KritSatthaphong/insole-force-monitor/README.md

# Insole Force Monitor

Live per-sensor force map for the A401 smart insole (EU42, 7 sensors per foot), both feet side by side.
Each foot stays greyed out until a board (or Demo) is connected to it.

**Open the app:** https://kritsatthaphong.github.io/insole-force-monitor/ (Chrome / Edge on a computer, Chrome on Android,
Bluefy on iPhone). Press **Demo** to try it without hardware.

| Folder | What |
|---|---|
| `firmware/FSR_Insole_App/` | ESP32-C6 sketch: raw mV of 7 channels at **200 Hz** (v1.4) over USB serial **and** BLE (batched v2 packet), with sample counter and MCU timestamp |
| `insole-app/index.html` | The app (single file, no install) |
| `tools/cal_from_xlsx.py` | Per-sensor loading / unloading fits from the UTM summary workbook (`S1-S7test results.xlsx`) — the app's defaults |
| `tools/fit_cal.py` | Older single-curve fit from the raw UTM CAL CSVs |
| `tools/check_cal.py` | Runs the app's mV → N conversion over a UTM CAL log and reports bias / RMSE / max error |

## 1. Flash the boards
Arduino IDE → board "ESP32C6 Dev Module", core 3.3.x, **USB CDC On Boot: Enabled** (Disabled also builds; then use
the CH343 port). Library: **SparkFun BMI270 Arduino Library** (Library Manager).
Firmware v1.3 also streams the BMI270 IMU (SDA GPIO23, SCL GPIO22; ±16 g, ±2000 °/s, read at 200 Hz) and subtracts the
measured gyro zero offset `GYRO_BIAS = {0.030, -1.175, 0.180}` °/s (mean of three 10 s still measurements); re-measure it if
the IMU board is replaced. The shock value (`apk`) is the peak dynamic acceleration |a − g| with gravity removed
(gravity tracked with the gyro on the board). Send `?`: `|a|` should read ≈ 1.00 g with the board lying still.
Flash the same sketch on both boards, then in Serial Monitor (115200) send `fL` to the left board and `fR` to the right one
(saved in flash; BLE name becomes `Insole-L` / `Insole-R`). Close Serial Monitor before using the app over USB.

## 2. Open the app
- **Laptop (USB or BLE), Chrome or Edge:** in the `insole-app` folder run `python -m http.server 8765`, open http://localhost:8765.
- **Anywhere (USB or BLE, incl. phones):** open the GitHub Pages link above. In **Chrome on Android** it works as is;
  iPhone Safari has no Web Bluetooth, so use the free **Bluefy** browser on iPhone.

Press **USB** / **Bluetooth** on the foot you want. The app zeroes automatically in the first second if the insole is unloaded;
otherwise press **Zero** with the foot off the insole.

## 3. Notes
- Channel → site (heel to toe): ch1 S1, ch2 S4, ch3 S6, ch4 S11, ch5 S13, ch6 S10, ch7 S14.
- Force: G = (mV/base − 1)/39 kΩ, F = a·G^b with each sensor's own fit from `S1-S7test results.xlsx`.
  **Hysteresis compensation** (on by default): the loading curve is used while a sensor's force rises, the unloading curve
  (scaled through the turning point) while it falls; each step starts again on the loading curve. Over 0–300 N this cuts the
  UTM error from 8–15 N to 2–8 N per sensor. Calibration → "Fit from a UTM workbook" fits a new .xlsx/.csv of the same layout
  in the browser (e.g. the right insole's sensors) into Left, Right or both; Save to use it.
  S3 has no unloading leg and S6 (ch6 = site S10, disconnected pins) no loading leg above 57 N: those channels use one curve.
- ≥ 3250 mV = ADC saturated → shown as `SAT` / `≥ value`.
- vGRF = Σ Fᵢ, the plain sum of the 7 calibrated sensor forces (no area or body-weight scaling), so it is the load on the
  sensors only and reads below the true foot load.
- Zero: channels at 250–350 mV set their base (VREF). A channel above that is preloaded: base stays ≈300 mV and the preload is
  subtracted in newtons. All channels high by the same amount → VREF shifted (warning shown).
- Live COP = Σ(rᵢ Fᵢ)/Σ Fᵢ, shown as two tiles, **COP X (ML)** and **COP Y (AP)** in mm, with the origin at the middle of the
  insole outline (X + = right side of the drawing, Y + = toward the toes). The current step's COP path is drawn on the insole
  with dashed centre lines marking X = 0 and Y = 0. Results add COP X / Y curves over % stance, per-step and summary values
  (heel strike, mean, toe-off, min / max) and X / Y over the whole recording; the CSV columns `COPx_mm` / `COPy_mm` use the same origin.
- Record → Stop & save downloads a CSV of every sample (mV, N, Fz, COP) and opens **Results**: gait events, walking
  speed / cadence / step & stride, vGRF peaks, impulse, loading rate, plantar pressure (peak kPa, PTI, contact area, COP path)
  as mean ± SD per foot, plus a per-step table and "Export steps CSV". Results also appear when a foot disconnects mid-recording.
- Walking speed: fill **Distance** (m walked during the recording) — or **Height** for an estimate. **Mass** adds %BW.
- **IMU (firmware v1.1+):** live heel-strike shock, foot pitch and eversion; in Results, IMU stride length and speed
  (zero-velocity updates), foot clearance, strike / toe-off angles, eversion and foot progression angle. Set how the BMI270
  sits in the insole under Calibration → IMU mounting. Default: sensor +Y points down (ay = −1 g standing) and +X to the heel,
  i.e. toe axis −X, up axis −Y. Results plot vGRF, foot pitch and eversion stacked on one % gait-cycle axis, angles 0° at heel strike.
- **BW cal / BW scale:** optional. BW cal on a foot measures factor = body weight / Σ sensor force while standing on that foot;
  the BW scale button multiplies vGRF by it (off by default, so vGRF stays Σ Fᵢ).
- **Calibration check** (in Calibration): runs the app's conversion over the built-in UTM data or a UTM file and shows
  bias / RMSE / max error per channel against ±52 N / ±20 N limits.

## 4. Logging over Bluetooth to a laptop or phone
Connect each foot with **Bluetooth**, press **● Record**, walk, press **■ Stop & save**. No cable or SD card is needed.
- Rows are saved in the browser's storage about once a second (header shows time · rows · saved). If the tab closes, the phone
  sleeps or the page crashes, the log is kept up to that second and appears under **Logs** as "recovered".
- **Logs** lists every recording in this browser: Download (laptop / Android → Downloads), **ZIP** (research export), **XML** (the same raw samples as an XML file),
  Share (phone → Files, Drive, e-mail), Delete. Tick **+ XML** next to ● Record to also download the XML automatically on Stop.
  The XML has one `<Sample>` per CSV row (t_ms, foot, src, Fz_N, COP, 7 `<Sensor id ch mV N>`, optional `<IMU>`), a `<Meta>` block
  with the CSV header lines and a `<Sites>` block with the sensor coordinates. It is about 4 times the CSV size.

## Research export (app 1.5.1-research, firmware 1.4)

For validation studies (e.g. against a pressure treadmill): enter **Participant / Run / Condition / Speed / Mass**, record, and Stop (or Logs → ZIP)
to get `P01_R01/` with `P01_R01_insole_L.csv` (raw mV, forces, CoP, IMU, `sample_seq`, device time `dev_us`, host receive time, validity and saturation masks),
`P01_R01_metadata.json` (calibration, baseline/tare, sensor positions, coordinate frames and the transform to the CAD corner frame, firmware, timing, counts)
and `P01_R01_events.csv` (zero, tare/calibration changes, link loss, packet drops, stream errors). Per-sensor calibration is now **linear**
(`N = m·(mV − baseline)`, from the PVC test on the insole); the earlier curve/hysteresis model is still selectable. Check an export with
`python tools/validate_export.py P01_R01.zip`; check the board itself with `python tools/hw_test_usb.py COM6`. Full documentation, schemas, test results, limits and the pre-lab checklist: [docs/RESEARCH_EXPORT.md](docs/RESEARCH_EXPORT.md).
- A dropped BLE link reconnects by itself for ≈40 s without losing zero, calibration or the recording; the status shows
  "% lost" from the packet counter, and the CSV has `dev_ms` (board time) plus BLE loss in its header line.
- The screen is kept awake while a foot streams over BLE or a recording runs (phones stop Bluetooth in the background):
  keep the app in front.

## UTM calibration test code

Sensor calibration on the Shimadzu UTM: see [`utm-calibration/`](utm-calibration/) (simple hold version and full v3.0 run-recording version, PC logger, pairing tool, results).
Browser logger for those sketches: https://kritsatthaphong.github.io/insole-force-monitor/utm-logger/ (Chrome / Edge).
