KritSatthaphong/insole-force-monitor/utm-calibration/results/S1_cycle1_39k_hold/S1_cycle1_CAL.csv

CAL | ms | ch | cycle | run | run_id | hold | dir | set_N | utm_N | mean_mV | sd_mV | min_mV | max_mV | early_mV | drift_mV | trend_mV | base_mV | rs_kOhm | g_uS | xtalk_mV | flags | redo | win_s
CAL | 17299 | 1 | 1 | 1 | UP01 | 0 | Z | 0.0 | 0.00 | 301.28 | 0.88 | 299 | 303 | 301.28 | 0.00 | 0.00 | 301.24 | -1.000 | 0.000 | 0.11 | 0 | 0 | 2.0
CAL | 131720 | 1 | 1 | 1 | UP01 | 1 | U | 100.0 | 99.80 | 485.12 | 0.93 | 483 | 488 | 480.74 | 4.38 | 0.78 | 301.24 | 63.894 | 15.651 | 0.28 | 0 | 0 | 2.0
CAL | 160471 | 1 | 1 | 1 | UP01 | 2 | U | 200.0 | 197.00 | 709.22 | 0.81 | 707 | 712 | 703.43 | 5.79 | 0.38 | 301.24 | 28.797 | 34.726 | 0.34 | 0 | 0 | 2.0
CAL | 213014 | 1 | 1 | 1 | UP01 | 3 | U | 296.0 | 296.00 | 948.09 | 1.31 | 945 | 952 | 939.57 | 8.53 | 1.75 | 301.24 | 18.163 | 55.058 | 0.41 | 0 | 0 | 2.0
CAL | 234817 | 1 | 1 | 1 | UP01 | 4 | U | 393.0 | 393.00 | 1192.75 | 1.08 | 1190 | 1196 | 1181.38 | 11.37 | 0.51 | 301.24 | 13.178 | 75.882 | 0.51 | 0 | 0 | 2.0
CAL | 284202 | 1 | 1 | 1 | UP01 | 5 | U | 495.0 | 495.00 | 1446.39 | 1.56 | 1442 | 1450 | 1436.34 | 10.05 | 1.81 | 301.24 | 10.259 | 97.471 | 0.56 | 0 | 0 | 2.0
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
