KritSatthaphong/insole-force-monitor/utm-calibration/results/older_47k/UTM_0002_CAL_only.csv

CAL | ms | ch | cycle | step | dir | set_N | utm_N | mean_mV | sd_mV | min_mV | max_mV | first_mV | base_mV | rs_kOhm | g_uS | xtalk_mV | flags | redo | frame0 | frame1
CAL | 524120 | 1 | 1 | 0 | U | 10.0 | 10.02 | 314.69 | 1.54 | 297 | 328 | 314.75 | 286.21 | 472.281 | 2.117 | 0.06 | 0 | 0 | 102128 | 102527
CAL | 557050 | 1 | 1 | 1 | U | 20.0 | 19.70 | 348.06 | 1.20 | 327 | 350 | 349.27 | 286.21 | 217.481 | 4.598 | 0.14 | 0 | 0 | 109756 | 110155
CAL | 618245 | 1 | 1 | 2 | U | 30.0 | 29.30 | 388.31 | 0.78 | 382 | 391 | 389.08 | 286.21 | 131.744 | 7.590 | 0.22 | 0 | 0 | 119304 | 119703
CAL | 664115 | 1 | 1 | 3 | U | 40.0 | 39.60 | 423.18 | 1.83 | 418 | 449 | 424.74 | 286.21 | 98.208 | 10.183 | 0.84 | 0 | 0 | 128971 | 129370
CAL | 691645 | 1 | 1 | 4 | U | 50.0 | 49.00 | 459.50 | 0.65 | 457 | 462 | 459.35 | 286.21 | 77.626 | 12.882 | 0.26 | 0 | 0 | 137079 | 137478
CAL | 730695 | 1 | 1 | 5 | U | 100.0 | 96.00 | 665.69 | 1.58 | 664 | 693 | 676.55 | 286.21 | 35.447 | 28.211 | 0.13 | 0 | 0 | 143905 | 144304
CAL | 758950 | 1 | 1 | 6 | U | 120.0 | 116.00 | 761.31 | 2.35 | 740 | 789 | 766.70 | 286.21 | 28.313 | 35.319 | 0.20 | 0 | 0 | 150443 | 150842
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
