KritSatthaphong/insole-force-monitor/utm-calibration/results/older_47k/UTM_S1_191028_CAL_rigidplate_RF47k.csv

CAL | ms | ch | cycle | step | dir | set_N | utm_N | mean_mV | sd_mV | min_mV | max_mV | first_mV | base_mV | rs_kOhm | g_uS | xtalk_mV | flags | redo | frame0 | frame1
CAL | 406598 | 1 | 1 | 0 | Z | 0.0 | 0.00 | 287.10 | 1.93 | 282 | 290 | 287.64 | 287.72 | -1.000 | 0.000 | 0.08 | 0 | 0 | 80153 | 80552
CAL | 468315 | 1 | 1 | 1 | U | 10.0 | 10.00 | 324.54 | 4.02 | 316 | 331 | 324.51 | 287.72 | 367.269 | 2.723 | 0.17 | 0 | 0 | 88259 | 88658
CAL | 533533 | 1 | 1 | 2 | U | 25.0 | 25.00 | 377.65 | 2.62 | 372 | 383 | 378.62 | 287.72 | 150.371 | 6.650 | 0.09 | 0 | 0 | 105258 | 105657
CAL | 560833 | 1 | 1 | 3 | U | 50.0 | 48.50 | 460.81 | 2.87 | 455 | 467 | 461.01 | 287.72 | 78.126 | 12.800 | 0.07 | 0 | 0 | 110283 | 110682
CAL | 588963 | 1 | 1 | 4 | U | 75.0 | 73.00 | 548.34 | 3.63 | 542 | 555 | 548.70 | 287.72 | 51.887 | 19.273 | 0.18 | 0 | 0 | 116557 | 116956
CAL | 621905 | 1 | 1 | 5 | U | 100.0 | 99.00 | 645.57 | 4.07 | 639 | 653 | 644.48 | 287.72 | 37.789 | 26.463 | 0.23 | 0 | 0 | 123305 | 123704
CAL | 651433 | 1 | 1 | 6 | U | 150.0 | 148.00 | 810.60 | 1.93 | 806 | 814 | 808.38 | 287.72 | 25.862 | 38.666 | 0.13 | 0 | 0 | 129034 | 129433
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
