KritSatthaphong/insole-force-monitor/utm-calibration/results/older_47k/UTM_S1_194814_CAL_pusheet_RF47k.csv

CAL | ms | ch | cycle | step | dir | set_N | utm_N | mean_mV | sd_mV | min_mV | max_mV | first_mV | base_mV | rs_kOhm | g_uS | xtalk_mV | flags | redo | frame0 | frame1
CAL | 2742395 | 1 | 1 | 0 | U | 10.0 | 9.00 | 312.70 | 0.63 | 311 | 314 | 314.55 | 287.55 | 537.370 | 1.861 | 0.05 | 0 | 0 | 547597 | 547996
CAL | 2785195 | 1 | 1 | 1 | U | 25.0 | 24.00 | 360.18 | 0.67 | 358 | 362 | 361.94 | 287.55 | 186.078 | 5.374 | 0.17 | 0 | 0 | 556396 | 556795
CAL | 2818278 | 1 | 1 | 2 | U | 50.0 | 45.00 | 422.36 | 0.78 | 420 | 424 | 428.98 | 287.55 | 100.251 | 9.975 | 0.16 | 0 | 0 | 562666 | 563065
CAL | 2851443 | 1 | 1 | 3 | U | 75.0 | 69.00 | 490.61 | 0.96 | 488 | 493 | 499.70 | 287.55 | 66.556 | 15.025 | 0.29 | 0 | 0 | 569046 | 569445
CAL | 2891053 | 1 | 1 | 4 | U | 100.0 | 91.00 | 551.52 | 0.87 | 549 | 554 | 565.59 | 287.55 | 51.198 | 19.532 | 0.14 | 0 | 0 | 576889 | 577288
CAL | 2928373 | 1 | 1 | 5 | U | 150.0 | 130.00 | 660.39 | 1.26 | 658 | 663 | 687.42 | 287.55 | 36.248 | 27.587 | 0.14 | 0 | 0 | 584261 | 584660
CAL | 2954353 | 1 | 1 | 6 | U | 200.0 | 184.00 | 831.08 | 1.15 | 828 | 834 | 855.66 | 287.55 | 24.865 | 40.217 | 0.18 | 0 | 0 | 589914 | 590313
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
