KritSatthaphong/insole-force-monitor/utm-calibration/results/S1_cycle1_39k_hold/S1_cycle1_mV_vs_N.png

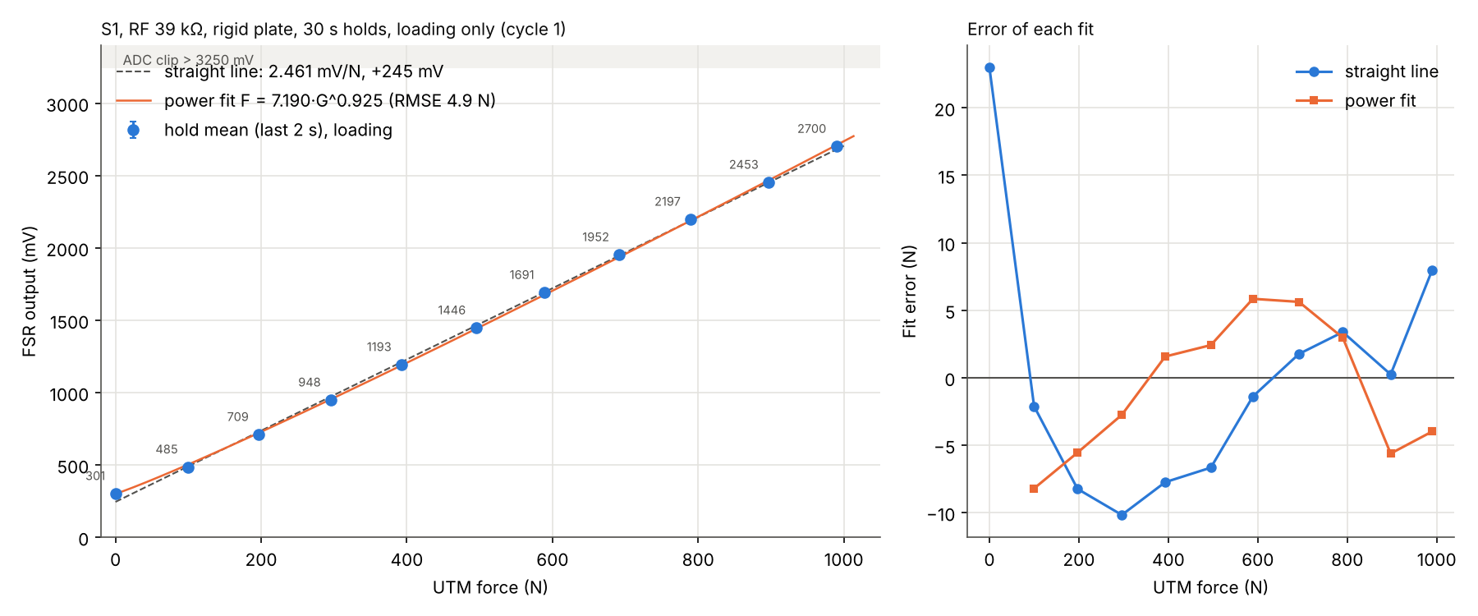
utm-calibration/results/S1_cycle1_39k_hold/S1_cycle1_mV_vs_N.png
