KritSatthaphong/insole-force-monitor/(commit log)

2026-10-29 Insole Force Monitor: web app, ESP32-C6 firmware and calibration tools
    Live per-sensor force map for the A401 smart insole (7 sensors per foot),
    USB and Bluetooth, per-sensor hysteresis calibration, gait results and
    Bluetooth logging. Served with GitHub Pages.
2026-10-29 Firmware v1.2: BMI270 IMU stream with gyro zero offset; add check_cal.py
    - FSR_Insole_App v1.2: BMI270 IMU at 200 Hz, 50 Hz frames over USB and a
    second BLE notify (6E400004); gyro bias {0.030, -1.175, 0.180} deg/s
    subtracted (mean of three 10 s still measurements)
    - tools/check_cal.py: compare the app's mV -> N conversion with a UTM CAL
    log; no crash on a missing branch or a non-CAL file
    [FSR_Insole_App.ino, check_cal.py]
2026-10-29 Web app: IMU display and analysis, BW cal, calibration check
    - Reads the BMI270 frames from firmware v1.1+ over USB and BLE (6E400004)
    - Live shock, foot pitch and eversion; IMU stride, speed, clearance, strike /
    toe-off angles, eversion and foot progression angle in Results
    - Optional body-weight factor per foot (BW cal, BW scale toggle)
    - Calibration check against built-in or loaded UTM data; IMU mounting setting
2026-10-29 IMU: new mounting, gravity-free shock, stacked gait-cycle charts
    - Default IMU mounting: sensor +Y down (ay = -1 g), +X to the heel
    (toe -X, up -Y); older saved mountings are reset to it
    - Firmware v1.3: shock = peak |a - g| per frame, gravity tracked with
    the gyro and corrected towards the accelerometer while still
    - Results: vGRF, foot pitch and eversion stacked on one % gait-cycle
    axis with FF / HO / TO lines; angles start at 0 deg at heel strike
    [FSR_Insole_App.ino]
2026-11-12 Add UTM calibration test code (simple hold version + full v3.0)
    - utm-calibration/FSR_UTM_Hold: simple sketch, h at each UTM hold, typed force, one CAL row per hold
    - utm-calibration/FSR_UTM_Cal: v3.0 run recording, hold detection, plan, events, baselines
    - utm_pc_logger.py v3: run files, reconnect, DTR, baud hint
    - tools/utm_pair.py: pair TRAPEZIUM X raw exports with run files, hold table + QC
    - dev: PC simulation and hold-detector unit test
    - results: S1 cycle 1 at 39k and older 47k runs
    Claude-Session: https://claude.ai/code/session_01AFbwC23sGGm54JrUkh3yNA
    [S1_cycle1_CAL.csv, UTM_0002_CAL_only.csv, UTM_S1_191028_CAL_rigidplate_RF47k.csv, UTM_S1_194814_CAL_pusheet_RF47k.csv]
2026-11-12 Add browser UTM logger and laptop presets (Toon COM5, Krit COM7)
    - utm-logger/index.html: Web Serial logger for FSR_UTM_Hold / FSR_UTM_Cal: laptop and baud presets,
    DTR option, run/h/save buttons, live hold table and mV-N plot, files saved on FILE_CLOSE
    (download or chosen folder), auto-reconnect, recovery of unsaved points
    - utm_pc_logger.py: --pc toon / --pc krit, baud hint
    - guides and README updated
    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
2026-11-12 Research export: 200 Hz firmware 1.4, linear PVC calibration, metadata/events/ZIP export
    Scope: data logging, export structure, metadata and data integrity. CoP formula and origin,
    ADC averaging, hysteresis model code, gait/IMU analysis and live visualisation are unchanged.
    Firmware 1.4: 200 Hz, uint32 sample counter + micros() acquisition timestamp on the USB line and
    in a batched BLE v2 packet, #TIMING diagnostics, 921600 baud, larger TX buffer.
    App 1.5.0-research: Linear calibration model (default, PVC test) with the curve model still
    selectable; seq/timestamp parsing with rollover handling; missing/duplicate/out-of-order tracking;
    Participant/Run/Condition/Speed fields; per-foot researc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
    [P00_R01_events.csv, P00_R01_insole_L.csv]
2026-11-12 App 1.5.1: USB baud auto-fallback; add hardware test script
    Connecting over USB only tried 921600 baud, so a board on older firmware (115200, CH343/UART
    port) showed "USB - waiting for data". The app now retries 115200 after 2.5 s without a
    recognisable line, and otherwise reports what it received and what to check.
    Also: tools/hw_test_usb.py (35 s USB check of firmware 1.4: rate, missing samples, MCU timing,
    #TIMING counters, mV at rest, channel response), checklist and version updates in the docs.
    Firmware unchanged (v1.4).
    [hw_test_usb.py]
